ICE-V-Wireless/ICE-V-Wireless/Hardware/README.md

# Hardware
This directory contains the hardware design for the ESP32C3 FPGA board. It is 
created using Kicad 6.x so you'll need an install of that to proceed.
