ICE-V-Wireless/ICE-V-Wireless/Gateware/spi_pass/README.md

# SPI Pass
This design passes the ESP32 SPI bus through the FPGA and to the PSRAM to enable
the ESP32 to read and write the contents of the PSRAM. This design is loaded
on-the-fly when required by the ICE-V-Wireless factory firmware.
