ICE-V-Wireless/ICE-V-Wireless/docs/3D_back.png

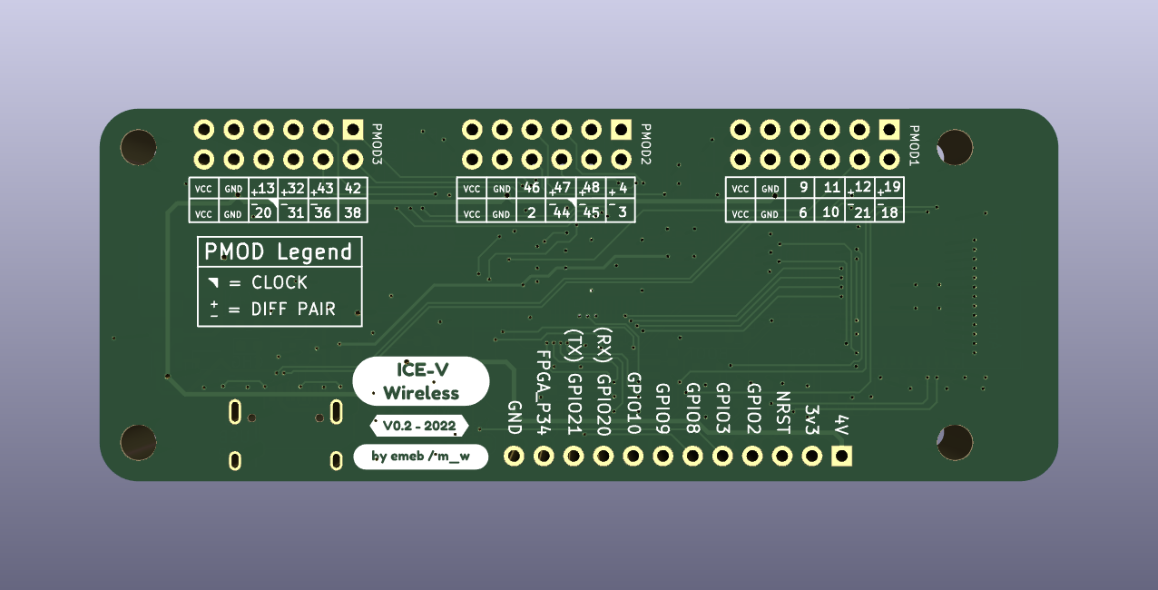
docs/3D_back.png
