ICE-V-Wireless/ICE-V-Wireless/docs/3D_front.png

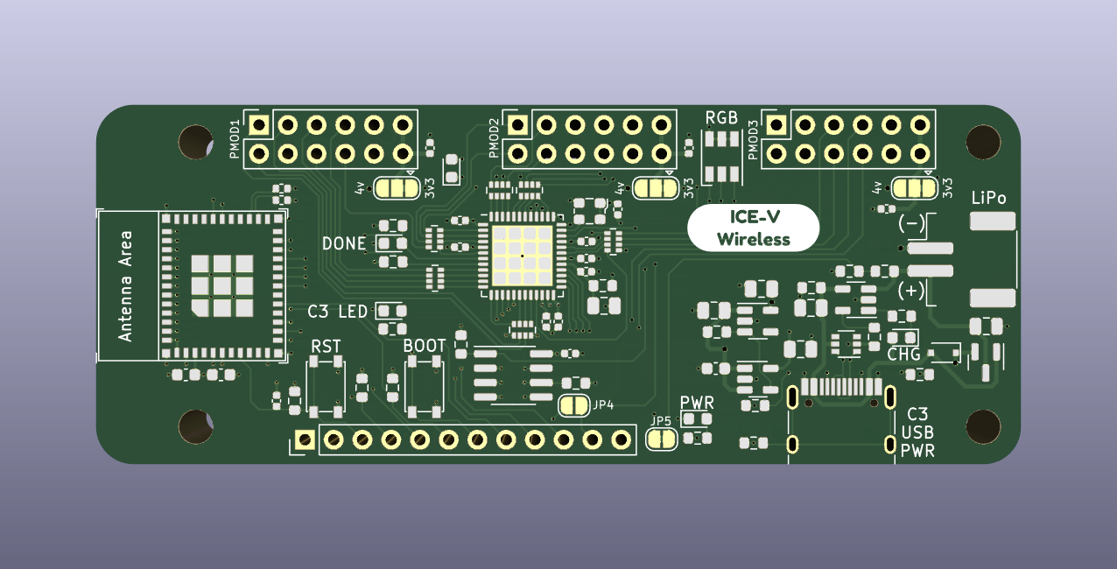
docs/3D_front.png
