ICE-V-Wireless/ICE-V-Wireless/docs/c3_fpga.jpg

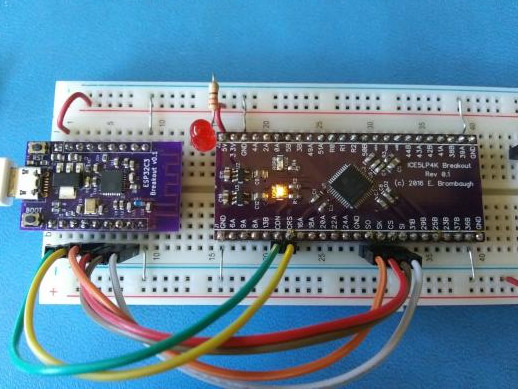
docs/c3_fpga.jpg
