ICE-V-Wireless/ICE-V-Wireless/docs/esp32c3_fpga_layout_v0.1.png

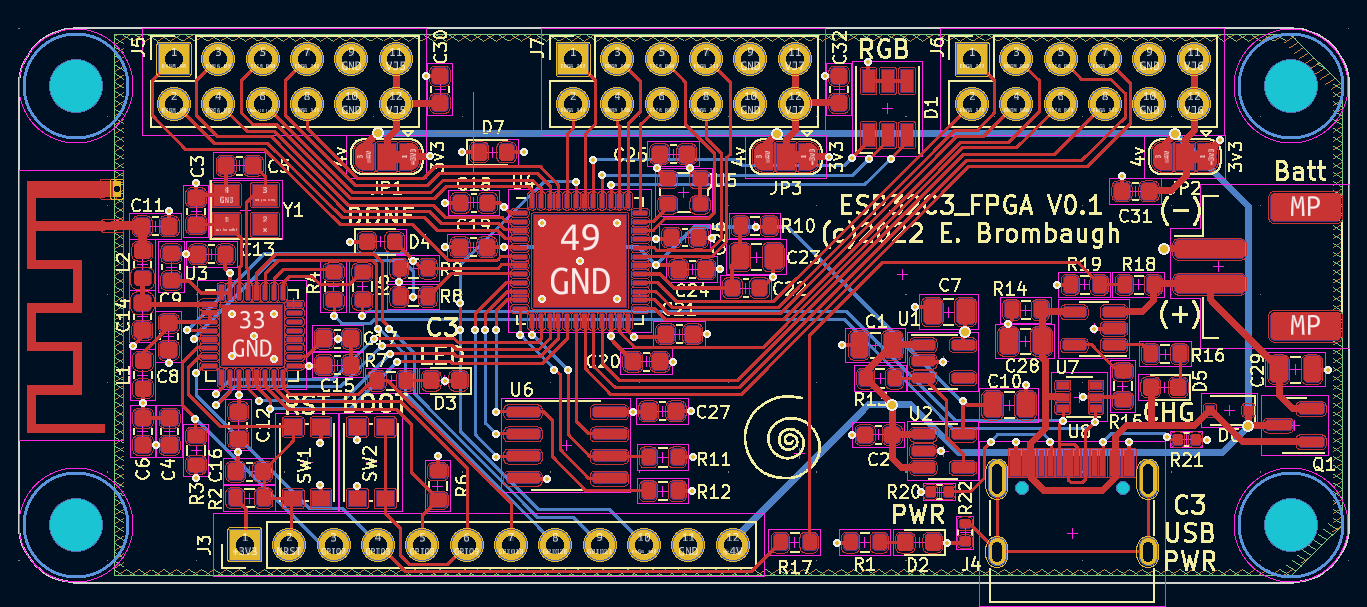
docs/esp32c3_fpga_layout_v0.1.png
