ICE-V-Wireless/ICE-V-Wireless/docs/rev0.1_photo.jpeg

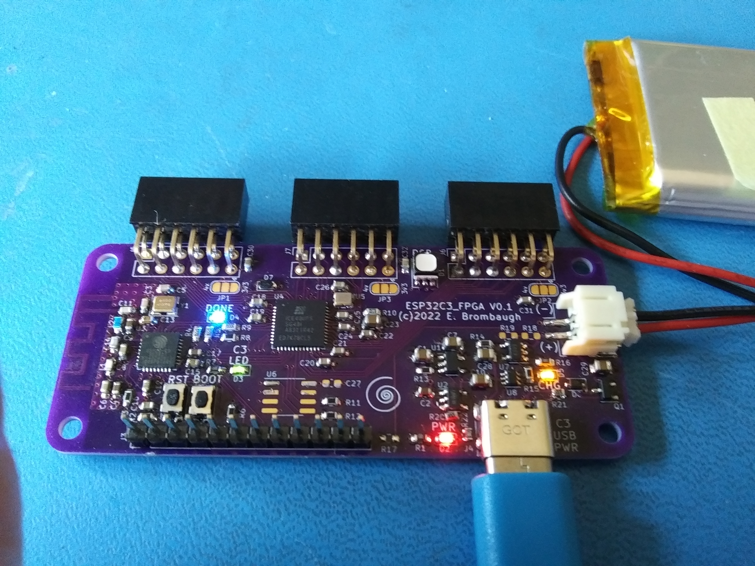
docs/rev0.1_photo.jpeg
