ICE-V-Wireless/ICE-V-Wireless/pinout/esp32c3_fpga_crop.png

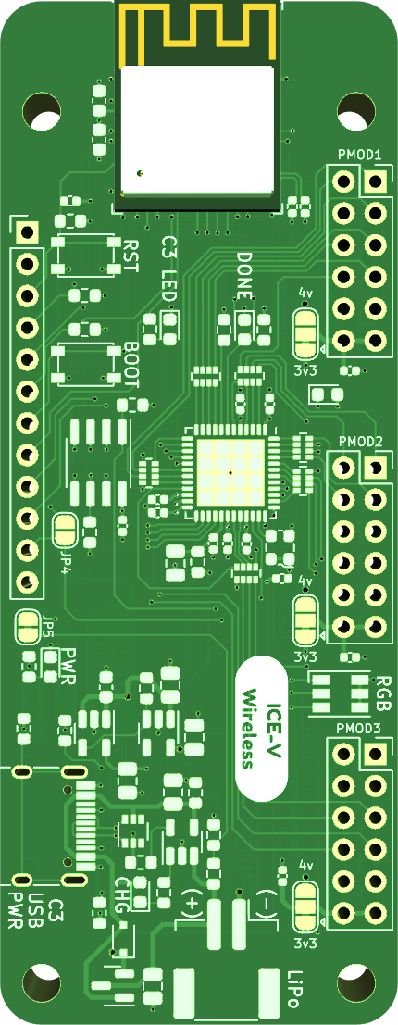
pinout/esp32c3_fpga_crop.png
