ICE-V-Wireless/ICE-V-Wireless/pinout/ice-v_front.png

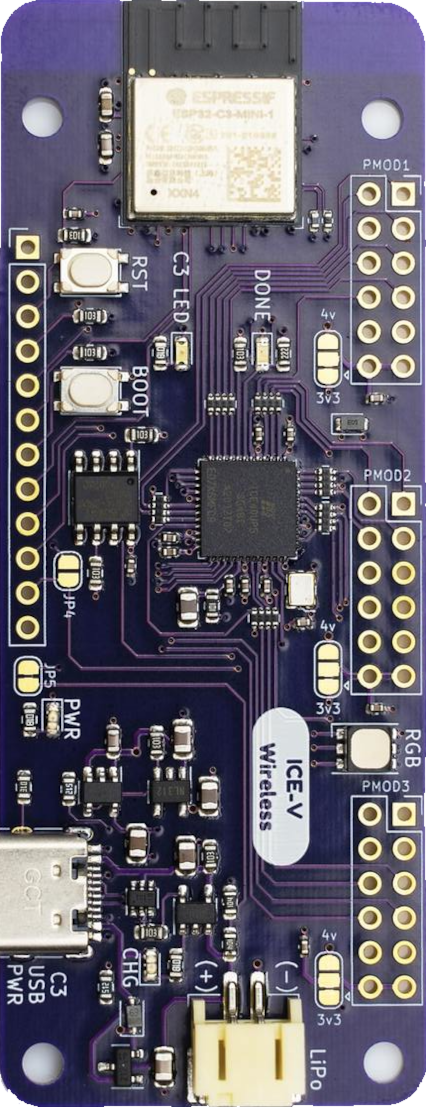
pinout/ice-v_front.png
