ICE-V-Wireless/ICE-V-Wireless/(threads)

Thread 2 (2022-08-01):

Testpoints on interface between ESP32C3 and iCE40UP5k

emeb, 2022-08-01:
When developing new software interfaces on the ESP32C3 it is sometimes helpful to have access to the hardware signals between the ESP32C3 module and iCE40UP5k FPGA. Adding testpoints to the six signals (SPI_PICO, SPI_POCI, SPI_CLK, SPI_CS, CDONE, CRESET) would be helpful. Nothing fancy - just some small pads to solder a wire to or touch with an oscilloscope probe that would be more easily accessible than the QFN pads of the FPGA.

mwelling, 2022-08-18:
Done!

Closed 2022-08-18.

Thread 9 (2022-09-21):

Adding the board to ICeStudio

benitoss, 2022-09-21:
You can add the board to ICEStudio but the command line to upload the bitstream based in python is not gonna work because you can not configure the port in Apio, it is fixed.
I can solve the problem of using different ports.

I have added to ICEStudio: Colorlight 5A-75B , 5A-75E, i9 , IceSugar pro and ECP5 Evaluation Board.
You can see my pull request in ICEStudio with the changes, if you want to do it yourself but you should be solve the problem of the different ports in your upload python script.

Usually the designers of the boards send me a prototype to accelerate the implementation.

My email is benitoss@gmail.com

emeb, 2022-09-22:
I'm not sure what the problem is - in both the WiFi and USB versions of the python loading scripts it is possible to specify the board IP address or USB device on the command line. Why can't that be passed in from Apio?

benitoss, 2022-09-22:
No, the problem is that you cannot pass a variable IP address or variable USB port com in the command line from ICEStudio to Apio to program the board.
The solution for the different COM in windows is to generate a Communication Port autodetection system in the windows binary, in Linux is easier because usually the port is the same always.

emeb, 2022-09-22:
OK, so the problem is that the invocation approach that icestudio uses to run the python loader scripts doesn't allow you to specify command line options for things like the serial port device or IP address. Your proposal is that the python loader script must autodiscover the appropriate IP address or COM port to use when running in Windows.

For WiFi use: It's *impossible* for the python script to determine what the IP address is - that's assigned by DHCP running on your LAN router and nothing short of an IP scan on your LAN will turn it up. The embedded firmware on the ICE-V-Wireless does support mDNS and the 'send_c3sock.py' script knows the correct mDNS name to use, but that only works if you've set up mDNS on your Windows box and not all users will have done so.

For USB Serial use: Autodetecting the USB CDC COM port that Windows assigns when the device is enumerated is not something I'm well-versed in. It may be possible to use the ESP32C3 VID:PID to cross-reference the COM port and I'll do some research to see if/how to do that.

emeb, 2022-09-23:
I've added some logic to the `send_c3usb.py` script which autodetects the ESP32C3 USB serial port on Linux. It *should* work on Windows as well, but I have some issues getting python scripts to work properly on Windows so testing by someone with a Windows system would be helpful.

benitoss, 2022-09-23:
I can test your python code but I don't have a ESP32C3 USB chip to test.
Will your python code work with other USB chip ?
As CH340, CP2102 , FT232H or FT2232H USB chips ??

emeb, 2022-09-23:
No, these python scripts work exclusively with the ICE-V-Wireless. They use a unique protocol to communicate over WiFi or USB-Serial with the ESP32C3 on the board and will not work with any other ice40 boards that are currently available.

benitoss, 2022-09-28:
Without a prototype is really complicated to generate a compatible driver for ICEStudio. The main idea is working with the USB-Serial connection of the ESP32C3 and work later with the Wi-Fi communication.
Let's wait them for the prototype

emeb, 2022-10-02:
We're looking a ways to support this. Looks like the best approach will be to add the ICE-V-Wireless to the supported boards list in APIO as described here:

https://apiodoc.readthedocs.io/en/stable/source/contribute/support_new_board.html

For the most part this seems to be a matter of adding to some JSON files, but there will be some additional effort required to provide our Python programming script(s) as packages that can be automatically fetched by the build system when the board is specified at init time. It's worth noting that the docs above do mention that a number of configuration settings can be passed down to the programmer from APIO using the ${variable} syntax, so apparently our serial port or IP socket addresses do not need to be hard-coded or automatically determined.

benitoss, 2022-10-03:
Yes, that is the way how to add your board to the APIO, but your serial COM port is not allways the same. You need to pass that variable from ICEStudio to APIO and that  variable cannot be passed.
Take the example of Alhambra Board, ICEStudio do not pass any information of the port of the FT2232H programmer included in the board. APIO uses iceprog aplication to program the board using only the VPI and VCI of the FT2232H to autodetect the  COM port.
You have to do something similar and create your aplication program that detects automatically the COM port.

ojg78, 2022-12-22:
Is this work ongoing? It will be disappointing to not be able to use the open source tool chain with my shiny new board.

mwelling, 2022-12-22:
@ojg78 The open source toolchain suite can and is being used for ICE-V Wireless. This is one of the primary reason we used the ICE40 FPGA.

This ticket is for interfacing the board with the IceStudio graphical front end via APIO. It is on-going.

ojg78, 2022-12-22:
Understood, thanks for the update and clarifying.

Thread 10 (2022-11-06):

build firmware and reflash esp32-c3

DaveBerkeley, 2022-11-06:
I can't see how build the firmware and reflash the esp32-c3.

Is there anywhere in the github contents that describes this?

Are there prebuilt ELF files that could be used?

mwelling, 2022-11-10:
See the README here:
https://github.com/ICE-V-Wireless/ICE-V-Wireless/tree/main/Firmware

DaveBerkeley, 2022-12-03:
Hi. I've tried building the code as directed. I installed the latest esp-idf from github.

idf.py build

gets a series of errors. Mostly around type errors in the logging and printf statements, where the type doesn't match the format string.

I've also tried "cmake ..; make" which seems to give better results than using ninja directly or though idf.py

Also getting "#include "mdns.h" no such file". I have installed esp-idf with all its components, including lwip which has the mds.h file.

Not sure how to proceed. How can I pass compiler options to the build system? menuconfig runs okay, but there is nowhere to eg turnoff the printf format checking that is causing errors. Also I'm presumably missing the lwip config somewhere.

emeb, 2022-12-05:
As noted in the README.md, the firmware was coded for ESP IDF V4.4.2 which was the stable version at the time the project was begun. Since then Espressif has released V5.0 as stable which has significant API changes that result in the build errors you're seeing. You can confirm you IDF version with this command:

idf.py --version

The correct response should be:

ESP-IDF v4.4.2

(Note that v4.4.3 should work too)

In order to build the firmware you'll need to make sure that you're using ESP IDF V4.4.2 - to get that follow these steps:

From Github:
1) Go to the IDF github page: https://github.com/espressif/esp-idf
2) Click the "Switch branches or tags" button in the upper left of the page to drop down a menu of available branches.
3) Scroll down to select branch "release v4.4"
4) Copy the repo URL using the green "Code" button in the upper right.
5) Clone the repo by your preferred method.

-OR-

From the ESP-IDF website:
1) Go to the IDF website: https://docs.espressif.com/projects/esp-idf/en/latest/esp32c3/get-started/index.html
2) Select V4.4.3 from the drop-down menu in the upper left
3) Follow the download instructions for your preferred OS

Then follow the usual setup steps for ESP IDF and build the ICE-V-Wireless firmware. Confirm you version with the
command above - note that V4.4.3 is the latest sub-version of V4.4 and should work fine.

DaveBerkeley, 2022-12-06:
I've pulled the v4.4.2 tag for the esp-idf tools. Now I get a series of cmake errors complaining about "Python requirements are not satisfied". Except I do have at least the first of these.

I'm going to give up. Anyone want to buy an unused ICE-V-Wireless board?

gojimmypi, 2022-12-06:
I'm willing to help if you want to try just a bit more.

DaveBerkeley, 2022-12-06:
That is very kind of you.

I'm happy building the bitstream. I have a project in mind using Amaranth and perhaps a risc-v. I didn't realise that the bitstream image was held on the ESP32. I have my own ESP32 framework, which I want to use, so ultimately I would be using different firmware anyway. I'll probably take a look at the SPI FPGA boot code and see if I can incorporate something similar into my framework.

I still need to work out how to get run-time comms between the two devices once the FPGA is booted. But I've written similar things before.

I was disappointed at the apparent fragility of the build. But this looks like being another back-burner project.

Thanks anyway (and Hi).

emeb, 2022-12-06:
Yes - as you noted, this system stores the FPGA bitstream in the ESP32C3 flash. The SPI communication for FPGA loading and control is all in the repo and is hopefully easy to understand. Note that we have a method for communicating between the ESP32 and FPGA over SPI after the design has been loaded and the routines for that as well as the Verilog code for the FPGA end are all available.

Not sure exactly why the ESP IDF isn't working for you - Python dependencies can sometimes be a nuisance to debug. In my experience the low-level SPI driver code needed to talk to the FPGA is generic enough that it should work in most all versions of IDF - the most version-sensitive stuff was mainly in the networking and flash access code.

DaveBerkeley, 2022-12-07:
Many thanks. Sorry I was being grumpy.

I've been working on an Amaranth SPI engine (on the ECP5) that allows an external device to rd/wr blocks of data directly into DRAM via a Litex DMA, for another project. I need to look at how PSRAM is used on the ice-v-wireless.

gojimmypi, 2022-12-07:
That's ok. We've all been there. :)

I'm interested in your work with Amaranth. Do you have a blog or ope

Closed 2022-11-21.

Thread 12 (2023-02-03):

Factory firmware build cannot use icebram

emeb, 2023-02-03:
The original factory firmware build process used icebram to allow updating the RISC-V firmware without rebuilding the entire gateware. This process works as long as OSS CAD Suite tools prior to 2022-05-19 are used. Tools after that date include changes to memory_libmap which can cause icebram to fail. See this issue:

https://github.com/YosysHQ/icestorm/issues/301

Since fixes to icebram to correct the failure are not yet in place, icebram has been removed from the build process.

Closed 2023-02-03.

Thread 13 (2023-05-03):

v4.4.2

renau, 2023-05-03:
The version used for IDF v4.4.2 does not seem to support macos ARM IDF v5.2 works fine with ESP32 (I tried with other boards).

The issue is that some of the firmware code is not correct for IDF 5.2. Any plan to migrate?

gojimmypi, 2023-05-03:
I see [IDF 5.2](https://github.com/espressif/esp-idf/tags) is still only development. I'm curious as to exactly which errors you are seeing with that version. I know the migration from 4.x to 5.x can be bumpy. Can you post some examples? thanks.

renau, 2023-05-03:
This is what I get when I try to compile the IDF-4.4.2 (I do not get any error with IDF 5.2)

```                                                                                                                                                                                                      ./install.sh
Detecting the Python interpreter
Checking "python" ...
/Users/renau/cse121/esp-idf-v4.4.2/tools/detect_python.sh: line 16: python: command not found
Checking "python3" ...
Python 3.11.3
"python3" has been detected
Installing ESP-IDF tools
Current system platform: macos-arm64
Traceback (most recent call last):
  File "/Users/renau/cse121/esp-idf-v4.4.2/tools/idf_tools.py", line 1860, in <module>
    main(sys.argv[1:])
  File "/Users/renau/cse121/esp-idf-v4.4.2/tools/idf_tools.py", line 1856, in main
    action_func(args)
  File "/Users/renau/cse121/esp-idf-v4.4.2/tools/idf_tools.py", line 1423, in action_install
    targets = clean_targets(args.targets)
              ^^^^^^^^^^^^^^^^^^^^^^^^^^^
  File "/Users/renau/cse121/esp-idf-v4.4.2/tools/idf_tools.py", line 1085, in clean_targets
    export_targets_to_idf_env_json(targets_from_tools_json)
  File "/Users/renau/cse121/esp-idf-v4.4.2/tools/idf_tools.py", line 1053, in export_targets_to_idf_env_json
    targets = list(set(targets + get_user_defined_targets()))
                                 ^^^^^^^^^^^^^^^^^^^^^^^^^^
  File "/Users/renau/cse121/esp-idf-v4.4.2/tools/idf_tools.py", line 1099, in get_user_defined_targets
    if env == idf_env_json['idfSelectedId']:
              ~~~~~~~~~~~~^^^^^^^^^^^^^^^^^
KeyError: 'idfSelectedId'
```

Thread 14 (2023-06-12):

ICE-V-Wireless in the LiteX

FelipeWcosta, 2023-06-12:
Hello everyone! It's only a question.

I just saw that ICE-V-Wireless board files is in the LiteX repository. So, can I load in FPGA of the board an CPU like VexRiscv directly just using LiteX and some tools more?

mwelling, 2023-10-02:
You can use the python scripts in this repository to program the boards with the artifacts after building using litex.

Thread 20 (2023-10-23):

No PDF of schematic/board design

twied21, 2023-10-23:
There is no easy way to see the full schematic or board design without first needing to download and install kicad and these separate design files. Would like to see a full PDF upload of at least the schematic as reference.
Thanks

emeb, 2023-10-23:
The schematic is in the docs directory here:
https://github.com/ICE-V-Wireless/ICE-V-Wireless/blob/main/docs/esp32c3_fpga_schematic.pdf

Closed 2023-10-23.

Thread 21 (2024-04-16):

ICE-V-Wireless NuttX RTOS support  - iCE40 programing driver

ppisa, 2024-04-16:
We are working with NuttX from about 2016 yer in university and industry projects and we have contributed more drivers over years. For ESP32C3, we have contributed CAN/TWAI driver in past and @janouja is working on PMSM control experiment with ICE-V-Wireless provided from RISC-V International Developer Boards program as part of his master's theses now and have implemented NuttX iCE40 programming driver and its mapping for ESP32C3.

Driver is part of NuttX mainline https://github.com/apache/nuttx/blob/master/drivers/spi/ice40.c . Mapping is provided for the esp32c3-devkit  which is now under  esp32c3-legacy. Mapping for new BSP variant requires to analyze new Espressif BSP approach.

The NuttX standard configuration for ESP32C3
```
tools/configure.sh esp32c3-devkit:nsh
```
needs to be adjusted by enabling ESP32C3_SPI2 and SPI_ICE40 options. Default offered pins mapping corresponds to one used on /ICE-V-Wireless. We even enable FS_ROMFS and ETC_ROMFS for our builds. The "/etc" mountpoint is specified by ETC_ROMFSMOUNTPT and such setup allow to include iCE40 bistream into "/etc" as another initial file.

Actual iCE-40 programming can be proceed by driver API under some user program control or directly by

```
cp ice_v_ice40_pmsm.bin /dev/ice40-0
```

The WIP project with PMSM control HDL design ported from functional IGL00 design for Raspberry Pi can be found in our GitLab https://gitlab.fel.cvut.cz/otrees/risc-v-esp32/ice-v-pmsm

If there is interest we will report as we progress further.

emeb, 2024-04-16:
This is fantastic news! Please do keep us updated on this.
We're planning another pass on the documentation in the near future and would like to include a section of links to related projects so we'll add yours.

ppisa, 2024-05-03:
The https://gitlab.fel.cvut.cz/otrees/risc-v-esp32/ice-v-pmsm project progress

The [PXMC](http://pxmc.org/) based application runs and controls PMSM motor in vector voltage DQ mode. The [HDL](https://gitlab.fel.cvut.cz/otrees/risc-v-esp32/ice-v-pmsm/-/tree/master/hdl/pmsm-control?ref_type=heads) design runs from 12 Mhz oscillator. We need to update it to 40 MHz internal one or PLL from 12 MHz. The original IGL00 with Raspberry Pi setup uses 50 MHz. So 48 MHz (4x 12) would be ideal.
Suggestion how to setup x4 PLL ideally from VHDL would be highly appreciated. We will see if 48 MHz is not too much for our design on iCE-40.
The next step is to try control PMSM motor in DQ current mode with PXMC application. Something like 4 kHz sampling frequency would be ideal but I expect that we do not reach that due to CPU throughput and NuttX scheduling and critical section blocking task switches limitations.
[pysimCoder](https://github.com/robertobucher/pysimCoder) works with the target as well and has been used for synchronous mode motor slow motion tests but it would be even more limited by CPU because it requires double support which software emulation is slow.
It would be ideal to implement forward and inverse Clarke and Park transformations for PWM and current sensing in iCE-40. But it seems to be task for some followup thesis. We have nice solution of these tasks on Zynq where this part of control is executed at 40 kHz synchronously with 20 kHz PWM by simple RISCV co-processor with sine and cosine accelerator engine etc. But porting it to small FPGA on ICE-V is probably impossible, even that minimal version of bare [RVapo](https://gitlab.fel.cvut.cz/otrees/fpga/rvapo-vhdl) has been tested to run on ICE-V's iCE-40. Rewrite to some state automata without CPU which could fit into iCE-40 should be possible but would be time consuming. So question is if/when there will be time/motivation or even some need from some company project.

emeb, 2024-05-03:
Impressive!
In my experience it's usually not hard to get 48MHz performance out of the Ice40 UP5k without too much effort. Generally a modest amount of logic between pipeline registers will be able to hit that speed. If you look in the ICE-V-Wireless Gateware directory at the factory bitstream top-level you'll find an example of instantiating the on-chip PLL in Verilog.
https://github.com/ICE-V-Wireless/ICE-V-Wireless/blob/bc6a02861e68a392a7c577059035db7d2b38b65a/Gateware/factory_bitstream/src/bitstream.v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
This is for a 24MHz output, but would be easily modified for 48MHz operation. I don't have any experience with using VHDL on the UP5k though so you'll have to figure that one out on your own.

ppisa, 2024-05-09:
I have solved somehow PLL in pure VHDL. Design allows only 30 MHz in its actual state

https://gitlab.fel.cvut.cz/otrees/risc-v-esp32/ice-v-pmsm/-/commit/55b6175b0ead6d96a60613cb2992eba873e91705

It would be interesting discuss with somebody who have idea how to interpret critical paths and how to update design.

Yosys/Nexpr seems to never use DSP blocks for adders, which is a shame. For wider additions it could be win. But I have tried to replace addition in the critical path by simple pass through of one source and limit frequency increased only by less than 1 MHz. So it seems that even manual rewrite of adders to use DSP MAC blocks world not help  considerably.

emeb, 2024-05-09:
Glad to hear you've got the VHDL instantiation of the PLL working.
The critical path(s) in each clock domain are noted in the nextpnr output logs - if you post the log I'd be happy to take a look. I wouldn't waste time rewriting to use the DSP adders until you've confirmed the critical path analysis indicates that the addition operations are where the problem is. You might find that merely adding pipeline stages in other parts of the design will help, but it's also possible that 32MHz is the limit for your design.

ppisa, 2024-05-10:
I am attaching the log

[ice_v_ice40_pmsm.log](https://github.com/ICE-V-Wireless/ICE-V-Wireless/files/15276554/ice_v_ice40_pmsm.log)

the critical path seems to be related to state automaton reading values from three ADC channels sensing Hall-effect current sensing oevr SPI bus. The [ADC state automaton](https://gitlab.fel.cvut.cz/otrees/risc-v-esp32/ice-v-pmsm/-/blob/pmsm-ice40-pll/hdl/pmsm-control/adc_reader.vhdl) runs in the fact at divided_clk which enables each 13-th  main_clk cycle because ADC allowed SPI frequency is limited. So there is lot of time for pipelining. But I am not sure what is so complex there except addition which I have tried to skip and did not helped much. The addition takes care to sum multiple samples for averaging.

emeb, 2024-05-11:
I agree the log shows the adder in your ADC state is the long path. One thing to remember is that often you find yourself in a game of "whack-a-mole" where fixing a long path in one area will just reveal one in another area. Since the logfile just shows you a few of the worst ones in each domain it's often hard to know how many different areas are likely to cause issues. You just have to keep plugging away at it.

ppisa, 2024-08-09:
PMSM three-phase voltage in Q component simple motor control application utilizing our PXMC - Portable, highly eXtendable Motion Control library ([https://www.pxmc.org/](https://www.pxmc.org/)) has been successfully demonstrated, running on 500 Hz (which is not optimal but limited by NuttX on ESP and SPI communication with FPGA). The project

[https://gitlab.fel.cvut.cz/otrees/risc-v-esp32/ice-v-pmsm](https://gitlab.fel.cvut.cz/otrees/risc-v-esp32/ice-v-pmsm)

The another experiment with pysimCoder (block diagram editor and real time code generator for Python  [https://github.com/robertobucher/pysimCoder](https://github.com/robertobucher/pysimCoder)) has been successful as well, but due need for double precision float arithmetic software emulation we have achieved only 200 Hz control loop sampling period. But even at that frequency the motor control and commutation is smooth on lower frequencies.

Jakub Janosek's diploma thesis is due for deference on September 2 and could serve as documentation for these interest in project.

ppisa, 2024-09-19:
Jakub Janousek has defended his thesis Open-source Motion Control on Mid-range and Small FPGAs

The  PDF with full text is available [https://dspace.cvut.cz/bitstream/handle/10467/117046/F3-DP-2024-Janousek-Jakub-DP_Janousek.pdf](https://dspace.cvut.cz/bitstream/handle/10467/117046/F3-DP-2024-Janousek-Jakub-DP_Janousek.pdf)

The project is updated and equipped by top level Makefile and build instructions.

[https://gitlab.fel.cvut.cz/otrees/risc-v-esp32/ice-v-pmsm](https://gitlab.fel.cvut.cz/otrees/risc-v-esp32/ice-v-pmsm)

ppisa, 2025-09-07:
For your information for ICE-V users where some can be interested in using [NuttX](https://github.com/apache/nuttx) on the devices:

I have tested NuttX-12.10.0 on the ICE-V device successfully with whole PMSM and OMK build. The minor export tweaks for [esp32c3-legacy](https://nuttx.apache.org/docs/latest/platforms/risc-v/esp32c3-legacy/index.html) esp32c3-devkit:nsh_icev configuration has been necessary

https://gitlab.fel.cvut.cz/otrees/risc-v-esp32/ice-v-pmsm

It would worth to enable iCE40 programming driver even for Espressif endorsed [esp32c3-generic:nsh](https://nuttx.apache.org/docs/latest/platforms/risc-v/esp32c3/index.html) support variant.

It should be relatively easy. Example for SPI mapping for [esp32c6-devkitc](https://nuttx.apache.org/docs/latest/platforms/risc-v/esp32c6/boards/esp32c6-devkitc/index.html)  can be found for example in our new Ethernet 10 BASE-T1S SPI MAC-PHY support in the @matiamic [oa-pr-esp](https://github.com/matiamic/nuttx/commits/oa-pr-esp/) branch.

By the way, adding support for SPI connected Ethernet 10 BASE-T1S SPI MAC-PHY to ICE-V board for NuttX would be easy as well.

It could be useful to report updates about NuttX option to broader ICE-V community probably if there are some such channels and list of showcases.
