ICE-V-Wireless/ICE-V-Wireless/docs/esp32c3_fpga_schematic.pdf

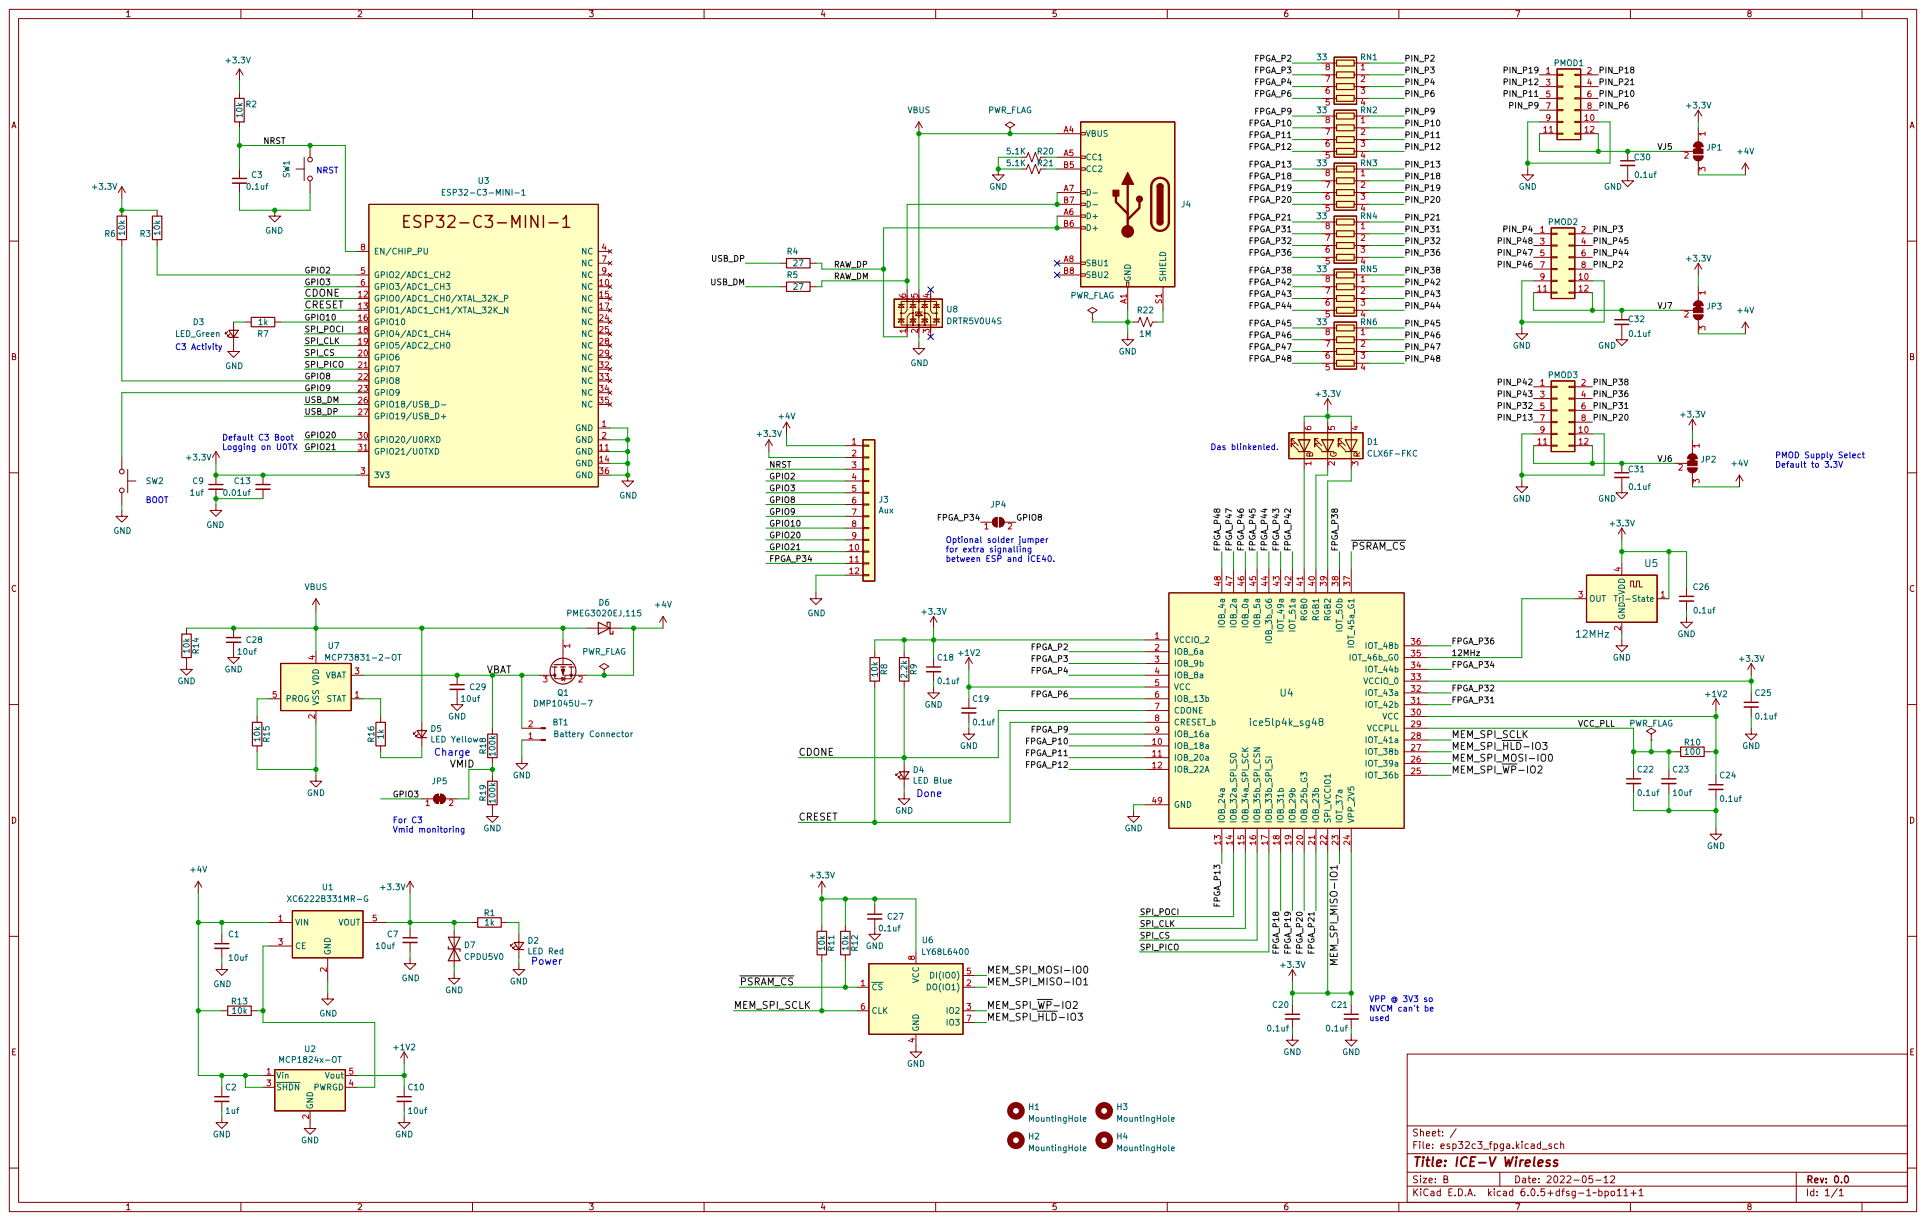
[picture p12: page 1]

PMOD Supply Select Default to 3.3V Das blinkenled. NRST

For C3 Vmid monitoring Default C3 Boot Logging on U0TX

VPP @ 3V3 so NVCM can't be

2 ~{SHDN} 3 PWRGD 4 Vout 5 U2 MCP1824x-OT GND

File: esp32c3_fpga.kicad_sch Sheet: /
Id: 1/1 Title: ICE-V Wireless
