ICE-V-Wireless/ICE-V-Wireless/(commit log)

2022-04-14 Updated HW design
    [esp32c3_fpga.kicad_pcb, esp32c3_fpga.kicad_sch]
2022-04-14 Remove plane stubs on left side
    [esp32c3_fpga.kicad_pcb]
2022-04-14 added charge label
    [esp32c3_fpga.kicad_pcb]
2022-04-15 Added ESD protection
    [esp32c3_fpga.kicad_pcb, esp32c3_fpga.kicad_sch]
2022-04-15 Swap in USB C, add PMOD bypass
    [esp32c3_fpga.kicad_pcb, esp32c3_fpga.kicad_sch]
2022-04-23 Updated w/ modified top copper and additional details in README
    [esp32c3_fpga.kicad_pcb]
2022-05-17 Fix schematic/layout errors found in first rev. Bump to v0.2
    [esp32c3_fpga.kicad_pcb, esp32c3_fpga.kicad_sch]
2022-05-17 Latest changes for hardware, includes configuration fix and credentials
    [ice.c, main.c, wifi.c]
2022-05-19 Added battery monitoring
2022-05-24 Switch to ESP32-C3-MINI module
    Adds ESP libraries. Need to credit them.
    May switch to a submodules for libs.
    [esp32c3_fpga.kicad_pcb, esp32c3_fpga.kicad_sch]
2022-05-24 Fix trace end DRC violations and tweak silk
    [esp32c3_fpga.kicad_pcb, esp32c3_fpga.kicad_sch]
2022-05-24 Update pin assignments for better IO block grouping
    [esp32c3_fpga.kicad_pcb, esp32c3_fpga.kicad_sch]
2022-05-24 Lots of updates
    - IOs moved around such that the IO banks line up on PMOD.
    - Adds 33 ohm series resistors to PMOD IOs.
    - Updates routing and tweaks the silkscreen.
    [esp32c3_fpga.kicad_pcb, esp32c3_fpga.kicad_sch]
2022-05-24 Update bottom silk and update pour apertures.
    [esp32c3_fpga.kicad_pcb]
2022-05-24 Add silkscreen docs
    [esp32c3_fpga.kicad_pcb]
2022-05-26 Silkscreen tweaks
    [esp32c3_fpga.kicad_pcb]
2022-05-28 Few routing tweaks and silk updates
    - Switch FPGA to ESP accessory GPIO jumper to GPIO8.
    - Switch location of pins on J3 to avoid having 4V and GND directly adjacent.
    - Moved the silk to adjusted J3 locations and added UART TX/RX annotation.
    - Other rando track push n' shove.
    [esp32c3_fpga.kicad_pcb, esp32c3_fpga.kicad_sch]
2022-05-28 More updates
    - Switch to different buttons that hopefully have a better feel.
    - Update silk even more.
    [esp32c3_fpga.kicad_pcb, esp32c3_fpga.kicad_sch]
2022-05-28 Switch button to PTS815
    [esp32c3_fpga.kicad_pcb, esp32c3_fpga.kicad_sch]
2022-05-28 Run DRC
    Fixes oopsies.
    [esp32c3_fpga.kicad_pcb]
2022-05-30 Fiddly routing changes
    [esp32c3_fpga.csv, esp32c3_fpga.kicad_pcb]
2022-06-13 Update schematic plot to latest
2022-06-14 Post interactive BOM
2022-06-16 Added READMEs, pinout and fix default python version
    [data.py, pinout_diagram.py, send_c3sock.py]
2022-06-17 Fix build errors due to SB_IO misconfigure
    [wb_bus.v]
2022-06-18 Updated pinout board image
2022-06-18 Update board images
2022-07-04 Fix missing flash configuration write option
    [send_c3sock.py]
2022-07-09 Update default gateware for dimmer RGB LED, remove unused stuff, add gitignores for intermediate files
2022-07-13 Move buttons away from misc connector and tidy some routing
    The buttons felt a tad close to the connector.
    [esp32c3_fpga.kicad_pcb]
2022-07-23 Correction to ESP32-C3 specific part number
    I believe the prior `ESP32C3HN4` is not a valid part number.
    I added a correction to note `ESP32C3F[H/N]4` (as either the "H" or "N" versions), as well as a hyperlink to the page of the ESP32-C3 datasheet
2022-08-05 Revert "Updated to work with latest ESP-IDF V5.0"
    This reverts commit ca9b0b8967b61eb380776dd23ec75bdd3298a265.
    [adc_c3.c, spi_pass.v, wifi.c]
2022-08-05 Updated to handle IDF V4.4.1 and V4.4.2, avoid PNR failures on timing
    [wifi.c]
2022-08-05 ci: build Gateware in CI
    This workflow installs requirements and builds Gateware
    using the OSS CAD suite.
2022-08-05 ci: build Gateware in CI
    run the gateware flow pull requests as well
2022-08-14 Adding secondary UART debug for when main logging disabled.
2022-08-14 add debug, fix some logic errors
    [sercmd.c]
2022-08-16 Working out bugs in reply process
    [send_c3usb.py, sercmd.c]
2022-08-17 Better reply handling, cleanups, error handling in firmware.
    [main.c, send_c3usb.py, sercmd.c, uart2.c]
2022-08-17 Add a bit more error checking and cleanups to python
    [send_c3usb.py, sercmd.c]
2022-08-18 Add various test points
    Add test points for:
    - Battery (VBAT, GND)
    - FPGA interface (CRESET, CDONE, PICO, POCI, CS, CLK)
    [esp32c3_fpga.kicad_pcb, esp32c3_fpga.kicad_sch]
2022-08-18 Added USB wifi credential setting. No longer hard-coded.
    [send_c3usb.py, sercmd.c, socket.c, wifi.c, wifi.h]
2022-08-19 Clean up SPI transactions
2022-08-21 Update documentation, clean up logging, add LED blink rate indicator
2022-08-22 Reduce memory footprint of wifi psram read
2022-08-24 Reduce Rnet pad width a bit for manufacturing
    To avoid voided solder mask between pads.
    [esp32c3_fpga.kicad_pcb, esp32c3_fpga.kicad_sch]
2022-09-06 Large PSRAM write file capability, USB serial malloc fail check
    [send_c3sock.py, send_c3usb.py, sercmd.c]
2022-09-29 Added PSRAM power-up init capability to WiFi control path
2022-09-30 Fix bug in ps_wr
    [send_c3usb.py]
2022-10-01 Handle init > 64kB. Note: > 110kB causes malloc failure
    [send_c3sock.py, send_c3usb.py]
2022-10-13 Flipped bidir TVS diode D7 in case unidir part accidentally used.
    [esp32c3_fpga.kicad_pcb, esp32c3_fpga.kicad_sch]
2022-12-27 Remove broken icebram from build flow.
2022-12-28 Add Schematic link to top-level README
2022-12-28 updated with Digi-Key purchase option and README for spi-pass design
